Exequiel25/Amplificador-Mono-1-W-discreto/Proyecto Final EA1-Magni Genre,Exequiel Juan.docx

Definición del problema:

Como parte de los requerimientos de aprobación y/o regularización de la materia Electrónica aplicada I se plantea la necesidad de construir un sistema que plasme/aplique los conocimientos adquiridos en dicha materia. Dicho trabajo deberá ser presentado funcionando (simulado) y con su respectivo informe.

Solución propuesta:

Construcción de un amplificador de guitarra de 1 W de potencia de verdadero valor eficaz.

Justificación:

Un amplificador de guitarra integra gran parte del contenido y conceptos del programa analítico de la materia. Por lo que resulta una buena opción como tema de trabajo final.

Temas del progrma incluidos:

- Tema 1: Señales y sistemas electrónicos
- Tema 2: Transistor bipolar con señales débiles
- Tema 3: Transistor unipolar con señales débiles
- Tema 4: Transistor con señales fuertes
- Tema 5: Estabilidad del punto de reposo
- Tema 6: Amplificadores multietapa
- Tema 7: Fuentes de corriente constante
- Tema 8: Amplificador diferencial
- Tema 9: Fuentes de alimentación lineales

Objetivos:

- Integrar y aplicar los conceptos vistos en la materia y en otras también.

Alcances y limitaciones:

El circuito está diseñado para trabajar en la banda de audiofrecuencias (20 Hz~20 kHz), aunque consideramos que la mínima frecuencia que puede generar una guitarra es 82,4069 Hz y la máxima frecuencia, para una eléctrica, es 1318,51 Hz fundamental y 3,5 kHz armónico. Al ser baja potencia (1 W) relativa a otros amplificadores, tendrá la limitación de no ser útil en espacios muy abiertos si el objetivo es conseguir un volumen considerable. Como ventaja, se puede ajustar para que sea utilizable con auriculares. Es de suma importancia saber que dicho amplificador está diseñado para operar con impedancias de entrada de entre los 5 a 15 kΩ y de carga de 6 u 8 Ω para parlantes y 32 Ω para auriculares, con respectivas adaptaciones.

Diagrama de bloques del amplificador para guitarra:

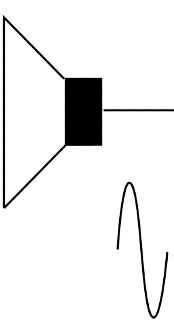
[picture p1: figure]

ETAPA ENTRADA

ETAPA AMPLIFICADORA

ETAPA ADAPTADORA

GUITARRA

(eléctrica o

acústica)

CARGA

8 Ω

Diagrama representativo de un Amplificador de Tensión:

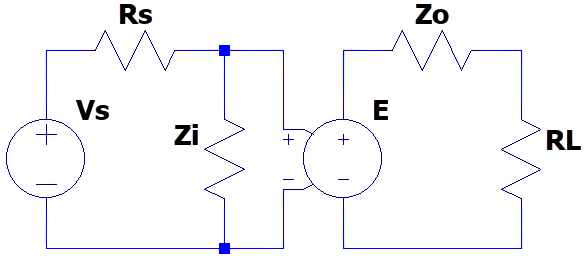
[picture p2: figure]

- Condiciones del amplificador:
  - Comprende señal de entrada desde Vs≈100mV hasta Vs≈200mV (según pastilla de bobinado en las eléctricas)
  - Zi≫Rs y Zo≪RL
  - La resistencia de salida (Rs) del instrumento es 5kΩ≤Rs≤15kΩ
  - Trabajamos con una resistencia de carga (parlante): RL=8Ω
  - Por lo tanto la impedancia de entrada debe ser Zi>200kΩ
  - Y la impedancia de salida debe ser Zo<10Ω
  - Potencia 1Wrms (este parámetro es obligatorio)

Síntesis:

Consideraciones:

Es lógico pensar que en el momento de usar un auricular no se alcance la misma potencia que cuando se utiliza un parlante de 8 Ω. Por lo tanto, la potencia de 1 W está apuntada al diseño para el parlante de 8 Ω.

La inversión de la señal a la salida del amplificador tiene relevancia cuando la salida es estéreo o cuando se realizan mezclas, lo que no es este caso.

Se debería agregar una Red de Zobel antes del parlante. Sin embargo, consideramos al parlante como una resistencia pura sin la necesidad de incluir dicha red. Tampoco se incluirá elementos de control de tono, volumen y ganancia.

Primer diseño propuesto:

En la primera etapa colocar un seguidor de fuente, el cual tiene baja ganancia de tensión (Av<1), pero su impedancia de entrada es elevada y su impedancia de salida es baja. A continuación, la segunda etapa sería un transistor bipolar en configuración de emisor común encargado de dar la ganancia de tensión necesaria del amplificador en su conjunto. Y la etapa adaptadora se conformaría de un seguidor de emisor, ya que su impedancia de entrada es elevada y su impedancia de salida es baja.

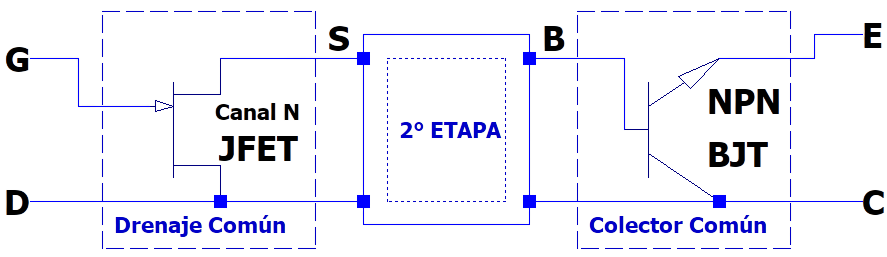
[picture p3: figure]

Este diseño conlleva muchas problemáticas debido a que la segunda etapa debía tener una ganancia muy elevada, ya que tanto la etapa de entrada como la etapa de salida tienen una ganancia de tensión inferior a 1, y esto a su vez llevaba a relaciones de compromiso con las impedancias de entrada y salida. Para mejorar dicha situación, se deberían agregar más etapas, haciendo más costoso al amplificador. Principalmente por este motivo, se decidió descartar esta idea.

Segundo diseño propuesto:

Comenzando desde la carga, se propone como etapa adaptadora, mantener un seguidor de emisor con un par Darlington, y así contrarrestar los bajos valores de β en los amplificadores de potencia. La etapa amplificadora constará también de un emisor común (BJT) o un surtidor común (JFET). Finalmente, para la primera etapa se sugiere un amplificador diferencial.

Dada las condiciones planteadas del amplificador de tensión, la mejor alternativa para la etapa de entrada es un amplificador diferencial, por la inmunidad al ruido, es con dispositivos FET, debido a su alta impedancia de entrada disminuyendo así valores de resistencias y, por lo tanto, el ruido térmico.

La ganancia será satisfecha gracias a la primera y segunda etapa, a diferencia del primer diseño. Esto permite valores de ganancia pequeños para mantener un gran ancho de banda (BW) del amplificador. Además, facilitamos el diseño para evitar distorsión en la señal amplificada y reducimos el valor de la fuente de alimentación de corriente continua (DC).

Finalmente, para la segunda etapa se obtó por un emisor común, el cuál lleva una ventaja respecto a la dispersión de parámetros de los dispositivos respecto a los JFETs. Este último se podría haber solucionado polarizando al dispositivo con una fuente de corriente, pero estoy lleva a encarecer y dificultar el diseño. Además, se volvió complicado diseñar una red de polarización tal que cumpliera con las especificaciones dadas, ya que la impedancia de salida de los JFETs en configuración de surtidor común es media-alta lo que no es eficiente para la transferencia de tensión.

Pasos del diseño ETAPA 3-Par Darlington:

1. Determinar el valor de la carga y forma de acople al amplificador.

R_L =8Ω , se acopla por medio de un capacitor.

2. Determinar corriente y tensión en la carga para que haya 1 Wrms

P_(RMS) =1W=(V_p^2)/(2R)=(I_p ²)/2R

    (a) V_(RMS) =(V_p)/(√2) , V_p =4,00V∧V_(RMS) ≈2,83V
    (b) I_(RMS) =(I_p)/(√2) , I_p =0,50A∧I_(RMS) ≈0,35A
3. Calcular corriente de emisor IEQ necesaria para que no haya distorsión:

I_(EQ) ≥I_(e(max)) =(V_(L(max)))/(R_E ∥R_L)

- Con R_E =12Ω :

I_(e(max)) ≈0,833A⇒I_(E(sat)) =I_(EQ) +I_(L(max)) ≈1,33A⇒(V_(CC))/(R_E)=1,33A⇒V_(CC) ≈16V

- Con R_E =20Ω :

I_(e(max)) ≈0,7A⇒I_(E(sat)) =I_(EQ) +I_(L(max)) ≈1,2A⇒(V_(CC))/(R_E)=1,2A⇒V_(CC) ≈24V

Se decide optar por RE=20 Ω para que haya una mayor transferencia de tensión hacia la carga.

4. Elección de transistores:

BC141: https://alltransistors.com/es/transistor.php?transistor=22321

BCP56: https://www.nxp.com/docs/en/data-sheet/BCP56_BCX56_BC56PA.pdf

Se elige 2 transistores BC141-16

5. Calcular RB

R_E ≫(R_B)/β⇒R_B <0.1βR_E =20,4kΩ ,, donde β=β_D =β_1 β_2 +β_1 +β_2 =10200conβ_(min) =100

V_(BB) =I_E (R_E +(R_B)/(β_D))+2V_(BE) ≈16,8V

R_(B1) =V_(CC) (R_B)/(V_(BB))≈29142Ω , se aproxima a valor comercial más cercano: 27 kΩ

R_(B2) =V_(CC) (R_B)/(V_(CC) −V_(BB))=68kΩ

Entonces:

R_(B1) =27kΩ∧R_(B2) =68kΩ⇒R_B ≈19,33kΩ , esta aproximación es un 5,25% más bajo que el límite establecido anteriormente R_B =20,4kΩ , es decir, estamos sacrificando un poco de estabilidad para obtener una mayor impedancia de entrada y aumentar la transferencia de tensión de la etapa anterior.

6. Calcular capacitores:

C_i ≈5/(πfR_B)→420nF∧C_o ≈5/πfR_E →440μF

7. Calcular impedancias:

Resistencia de entrada a la base: R_(ent(base)) =(V_(ent))/(I_(ent))=(V_b)/(I_b) ; siendo V_b =I_e (r'_e +r'_e +R_E ∥R_L ) y I_b =(I_e)/(β_(ac)) .

R_(ent(base)) =(I_e (2r'_e +R_e ))/((I_e)/(β_(ac)))⇒R_(ent(base)) =β_(ac) (2r'_e +R_e ) ; r'_e ≈(25mV)/(I_(EQ))≈35,71mΩ

  a) Impedancia de entrada: Z_i =R_B ∥R_(ent(base)) ≈15,4kΩ
  b) Impedancia de salida: Z_o ≈R_E ∥R_L ≈5,71Ω
8. Calcular ganancia:

A_v =(V_o)/(V_i)=(V_e)/(V_b)=(I_e R_e)/(I_e (2r'_e +R_e ))=(R_e)/(2r'_e +R_e)≈0,988 ; cumple el objetivo de llevarla lo más cercano a 1

Este valor impone una condición sobre las demas etapas.

Siendo que A_(vTotal) =(V_o)/(V_i)=(4,05)/(0,1)=40,5=A_(v1) ⋅A_(v2) ⋅A_(v3) ⇒A_(v1) ⋅A_(v2) =(40,5)/(A_(v3))≈41 ; por lo tanto, podemos proponer ganancias de 10 y 4 para las etapas 1 y 2. Es conveniente que la primer etapa sea la que más amplifique debido a que su señal de entrada es más débil.

9. Simulación

La tensión que debe llegar a esta etapa es V_(i3) =4,15V . De la simulación obtenemos los siguientes datos:

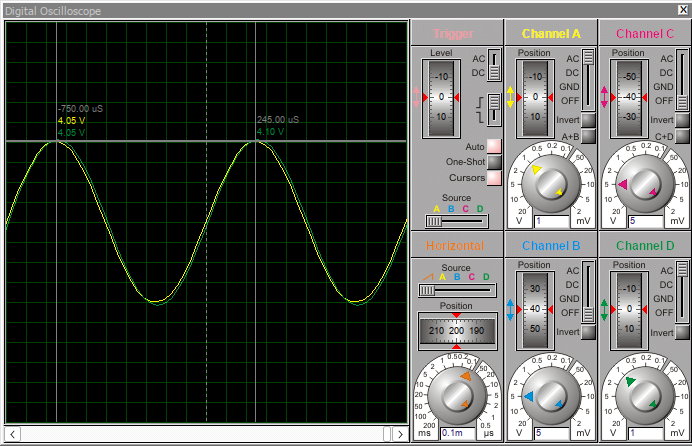
[picture p4: figure]

V_o =4,05V⇒ϵ_((%)) =(4,05−4,00)/(4,00)x100=+1,25%

A_v ≈0,98

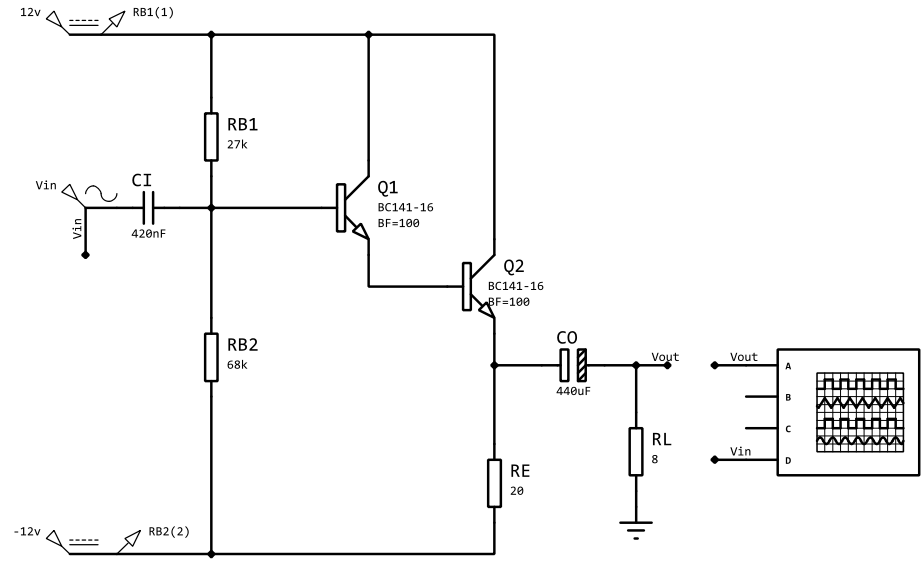
[picture p5: figure]

Transistor Q1:

V_(CEQ) =8,876V

I_(EQ) =7,264mA

P=64,54mW

El dispositivo no requiere de disipador.

Transistor Q2:

V_(CEQ) =9,821V

I_(EQ) =733,6mA

P=7,212W ; verificar

Debido a que la potencia del transistor Q2 supera los 3,7 W (potencia PD que disipa el encapsulado) se debe agregar un disipador.

Modelado térmico:

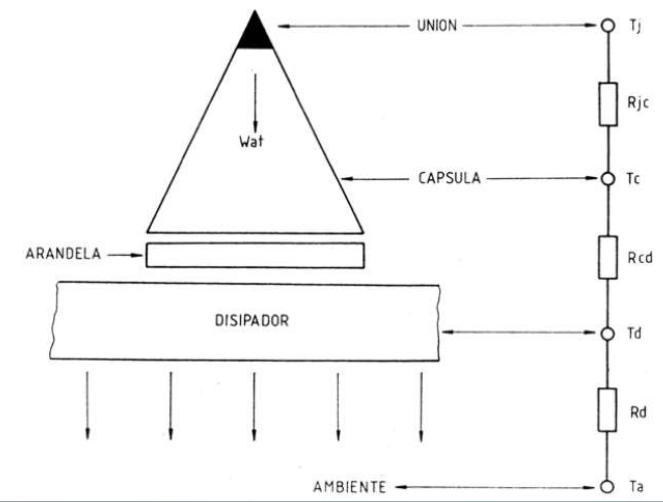
[picture p6: figure]

Circuito equivalente:

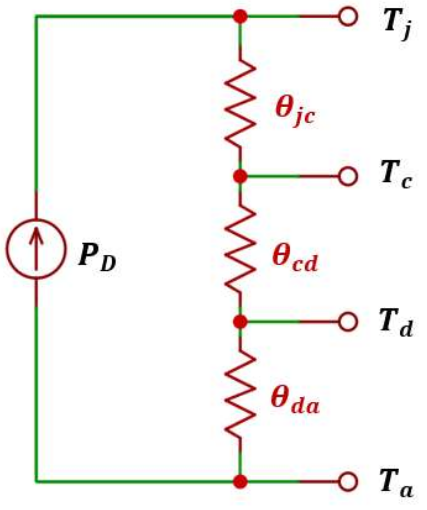
[picture p7: figure]

Del datasheet obtenemos los datos, el único problema es que hay un error en el datasheet encontrado anteriormente, por lo que se recurrió al siguiente:

https://www.st.com/resource/en/datasheet/cd00003226.pdf

P_D =7,212W ; T_(j−max) =175°C ; −65°C<T_a <150°C ; R_(θ−ja) =200°C/W ; R_(θ−jc) =35°C/W

Corroboramos la necesidad de calcular un disipador:

7,212W=(T_j −T_a)/(θ_(ja))⇒T_j ≈1467,4°C>T_(j−max)

Hacemos que Tj esté lo menos cercano al valor Tj máximo T_j =kT_(j−max) donde 0,5≤k≤0,7

Por criterio, podemos obtar por un k=0,6 para economizar las dimensiones del disipador. Entonces:

P_D =(kT_(j−max) −T_a)/(θ_(jc) +θ_(cd) +θ_(da)) ; donde kT_j =105°C

Siendo que elegimos contacto directo con grasa siliconada y el encapsulado es TO-39: R_(θ−cd) =0,7°C/W

Entonces:

θ_(da) =(kT_(j−max) −T_a)/(P_D)−(θ_(jc) +θ_(cd) )≈−24,61°C

Observamos que el valor es negativo, es decir, no existe un disipador que permita trabajar en estas condiciones. Podemos llevar k a un valor de 0,7: θ_(da) ≈−22,18°C . Vemos que el valor sigue siendo negativo, por lo que otra solución sería recurrir a la refrigeración forzada por medio de ventiladores, aunque para la naturaleza del proyecto esta opción queda descartada. Vemos que el problema radica principalmente en que la resistencia juntura-carcasa máxima posible, indicada por el fabricante, es muy elevada. Por ende, sería conveniente buscar otro transistor.

Dado que el diseño de la etapa ya fue realizado, es conveniente buscar un transistor que posea características similares, pero mejore la disipación de potencia.

Un candidato es el BUP41: https://pdf1.alldatasheet.es/datasheet-pdf/view/441217/ISC/BUP41.html

Con el cual, según indica el fabricante (http://www.iscsemi.cn/en/list/?84_1.html), se garantiza disipar 10 W de potencia, por lo que no sería necesario agregar un disipador.

Vemos en la simulación que no hay mucho cambio debido a que el diseño se realizó para transistores con un beta mínimo de 100.

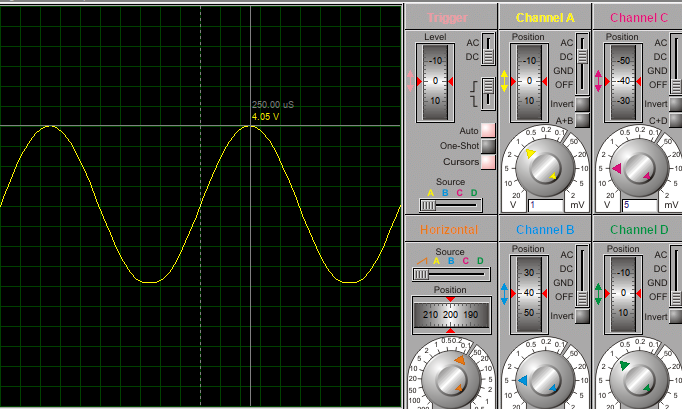
[picture p8: figure]

Pasos del diseño ETAPA 2-Emisor Común:

1. Condiciones fundamentales de la etapa:

A_v =−4,2

Z_o ≪Z_(i(etapa3)) =14,56kΩ⇒Z_o ≤1456Ω

10. Calculos para obtener ganancia de tensión y corriente requerida para evitar la distorsión:

A_v =(−R_c)/(r'_e)≈(R_c)/((25mV)/(I_(CQ)))=(I_(CQ) R_c)/(25mV)

Si R_C =1kΩ⇒R_c ≈943,25Ω∧I_(CQ) ≈111,32μA

I_(CQ) ≥I_(c(max)) =(V_(o(max)))/(R_C ∥R_L) ; V_(o(max)) =4,15V

I_(CQ) ≥4,4mA La corriente de alterna para obtener determinada ganancia no coincide con la mínima necesaria para evitar distorsión.

Introducimos una resistencia RE para alterna.

A_v =(−R_c)/(R_E +1/(g_m)) ; si R_E ≫1/(g_m)⇒A_v ≈(−R_c)/(R_E)

R_E +1/(g_m)≈(R_c)/(A_v)≈224,58Ω∧R_E =10/(g_m)⇒g_m ≈48,98mS=(I_(CQ))/(25mV)⇒I_(CQ) ≈1,22mA

R_E =200Ω ; pero la corriente resultante sigue siendo menor que la corriente necesaria para no provocar distorsión. Por ende, añadimos una segunda resistencia RE en paralelo con un capacitor y así no influenciar el cálculo de la ganancia.

I_(CQ) =4,5mA ; R_(E1) =200Ω

V_(CC) −I_(CQ) R_C −V_(CEQ) −I_(EQ) R_E =0⇒R_E ≈1,667kΩ

R_E =R_(E1) +R_(E2) ⇒R_(E2) =R_E −R_(E1) ≈1,5kΩ

11. Elección del transistor:

BC548: https://pdf1.alldatasheet.es/datasheet-pdf/view/11552/ONSEMI/BC548.html

12. Calcular RB

R_B ≤0,1βR_E ≈17kΩ , donde β_(min) =100

V_(BB) −I_B R_B −V_(BE) −I_E R_E =V_(EE) ⇒V_(BB) =I_E (R_E +(R_B)/(β_D))+V_(BE) ≈9,746V

R_(B1) =V_(CC) (R_B)/(V_(BB))≈44761Ω→43kΩ

R_(B2) =V_(CC) (R_B)/(V_(CC) −V_(BB))≈27410→27kΩ

Entonces:

R_(B1) =43kΩ∧R_(B2) =27kΩ⇒R_B ≈16,59kΩ , es un 0,001% más bajo que el límite R_B =17kΩ

13. Calcular capacitores:

C_i ≈5/(πfR_B)→480nF∧C_o ≈5/πfR_C →8μF∧C_E ≈5/(πfR_(E2))≈6uF

14. Calcular impedancias:

Resistencia de entrada a la base:

R_(ent(base)) =(V_b)/(I_b)=(I_e (r'_e +R_(E1) ))/((I_e)/(β_(ac)))=β_(ac) (r'_e +R_(E1) )≈20,52kΩ

  a) Impedancia de entrada: Z_i =R_(ent(base)) ∥R_B ≈9,17kΩ
  b) Impedancia de salida: Z_o ≈R_c =R_C ∥R_L ≈935,73Ω
15. Calcular ganancia:

A_v =(V_o)/(V_i)=(V_c)/(V_b)=(I_c R_c)/(I_c (r'_e +R_(E1) ))=(R_c)/(r'_e +R_(E1))≈4,561

16. Simulación

La tensión que debe llegar a esta etapa es V_(i2) =1V . De la simulación obtenemos los siguientes datos:

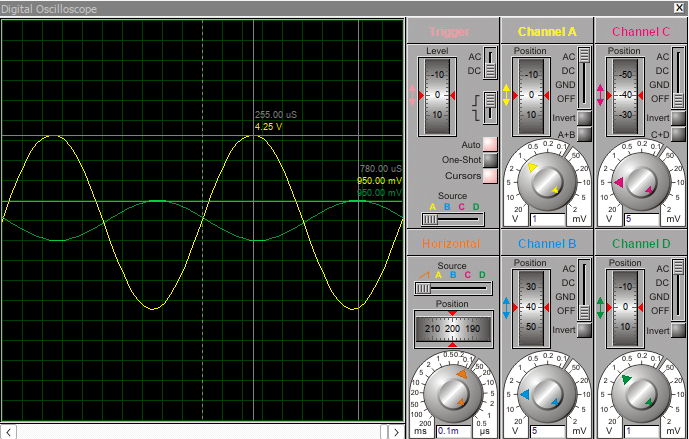
[picture p9: figure]

V_o =4,25V⇒ϵ_((%)) =(4,25−4,15)/(4,15)x100=+2,4%

A_v =−4,25⇒ϵ_((%)) =(4,25−4,2)/(4,2)x100=+1,19%

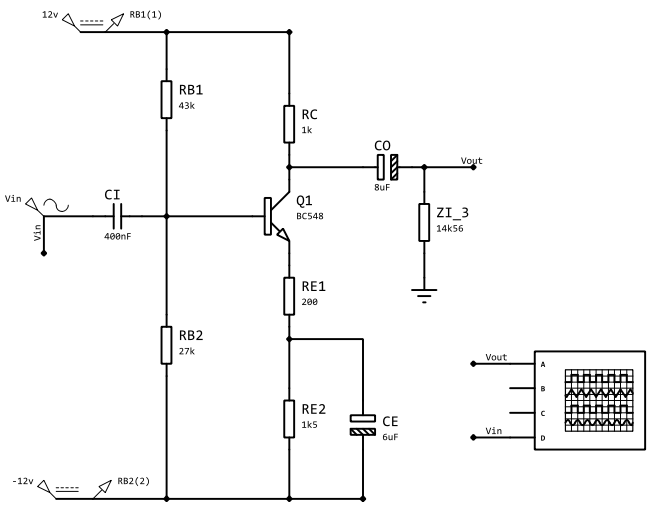
[picture p10: figure]

Transistor Q1:

V_(CEQ) =10,27V

I_(EQ) =5,518mA

P=56,69mW

El dispositivo no requiere de disipador.

Pasos del diseño ETAPA 1-Amplificador Diferencial (JFETs):

Se usará en modo diferencial, donde la entrada no inversora se conecta a masa y se inyecta la señal por la entrada inversora.

Se supone que los transistores son iguales.

Por el rechazo en modo común la señal no deseada (ruido) que aparece comúnmente en ambas entradas de un amplificador diferencial se anula.

Configuración salida asimétrica – entrada asimétrica.

La ganancia en modo común disminuye drásticamente al polarizar con una fuente de corriente constante, ya que la resistencia de fuente es una resistencia de gran valor. En consecuencia aumenta CMRR y la impedancia de entrada en modo común (menos sensible al ruido). Además, una ventaja de polarizar con una fuente de corriente implica mayor estabilidad.

1. Condiciones fundamentales de la etapa:

A_v =−9,84≈−10 ; debido a que por aproximaciones suele ser menor.

Z_o ≪Z_(i(etapa3)) =9,26kΩ⇒Z_o ≤926Ω

17. Calculos para obtener ganancia de tensión y corriente requerida para evitar la distorsión:

A_(dm) =(g_m R_d)/2=(I_(DSS))/(V_p)(1−(V_(GS))/(V_p))R_d

I_(DSS) =10mA∧V_(GS(off)) =V_p =−1V

Con R_D =900Ω⇒R_d ≈820,28Ω

I_(DQ) ≥I_(d(max)) =(V_(o(max)))/(R_D ∥R_L) ; V_(o(max)) ≈1V

I_(DQ) ≥1,22mA

A_v =(g_m R_D)/2⇒g_m =2(A_v)/(R_D)≈22,22mS ; g_m =2(I_(DSS))/(V_p)(1−(V_(GS))/(V_p))⇒V_(GS) =−0,111 ;

I_D ≈I_(DSS) (1−(V_(GS))/(V_p))^2 ≈7,9mA ; es mayor que la corriente de drenaje mínima.

18. Elección del transistor:

2N3819: https://pdf1.alldatasheet.es/datasheet-pdf/view/111087/VISHAY/2N3819.html

19. Calcular fuente de corriente para polarización:

R_E =(V_(EE) −V_(BE))/(2I_(DQ))≈715,19Ω→680Ω

20. Calcular capacitores:

C_o ≈5/πfR_C →10μF

21. Recalcular ganancia:

A_v =(g_m R_D)/2=(I_(DSS))/(V_p)(1−(V_(GS))/(V_p))R_D ≈10

22. Simulación

La tensión que debe llegar a esta etapa es V_(is) =100mV . De la simulación obtenemos los siguientes datos:

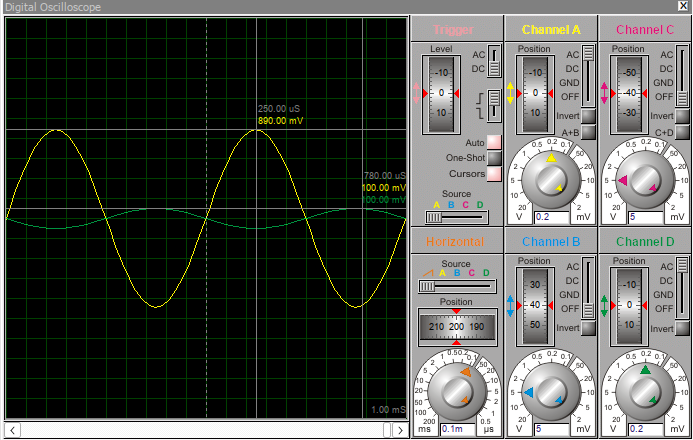
[picture p11: figure]

V_o =0,89V⇒ϵ_((%)) =(0,89−1)/1x100=−11%

Vemos que el valor de tensión de salida supera el 10% de error. Realizamos entonces una pequeña correcón en la fuente de corriente, la cuál está entregando un valor de corriente inferior a la requerida.

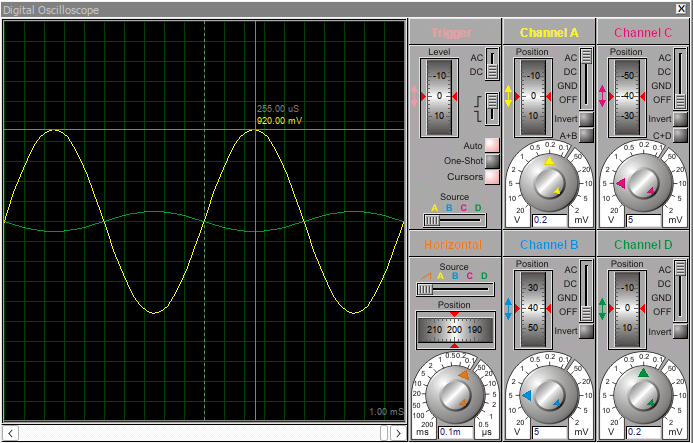
[picture p12: figure]

V_o =0,92V⇒ϵ_((%)) =(0,92−1)/1x100=−8%

A_v =−9,2⇒ϵ_((%)) =(9,2−10)/10x100=−8%

Es un valor más aceptable, por lo que se procede al ensamble del amplificador.

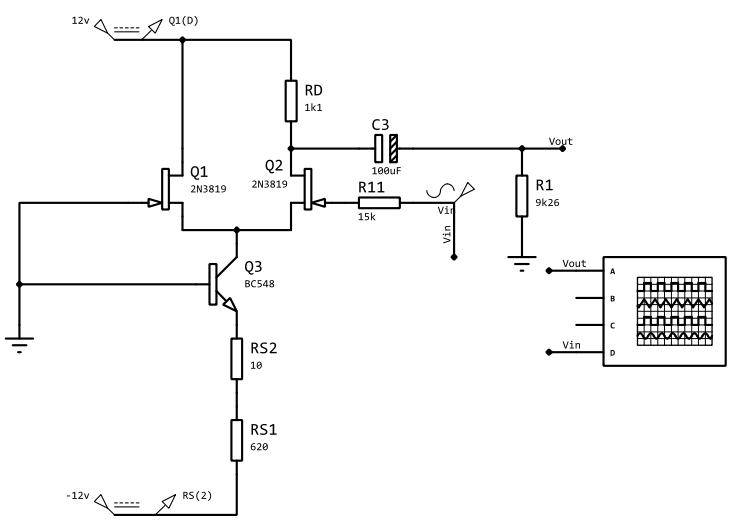
[picture p13: figure]

Transistor Q1:

V_(DSQ) =11,94V

I_(DQ) =8,874mA

P=106mW

Transistor Q2:

V_(DSQ) =2,19V

I_(DQ) =8,864mA

P=19,42mW

Transistor Q3:

V_(CE) =821,9mV

I_(DQ) =17,74mA

P=14,65mW

Ningún dispositivo requiere de disipador.

Simulación del amplificador diseñado

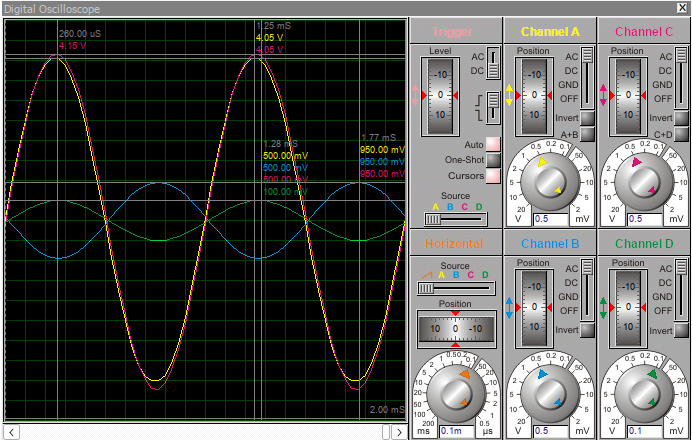
[picture p14: figure]

Legenda:

V_(oL) =4,05V⇒ϵ_((%)) =(4,05−4,05)/(4,05)x100=0% Amarrillo = Señal de salida en la carga

V_(o1°) =950mV⇒ϵ_((%)) =(0,95−1)/1x100=−5% Azul = Señal de salida de la primera etapa

V_(o2°) =4,15⇒ϵ_((%)) =(4,15−3,97)/(3,97)x100=+4,53% Rojo = Señal de salida de la segunda etapa

V_i =100mV;f=1kHz Verde = Señal de salida del instrumento / Señal de entrada al amplificador

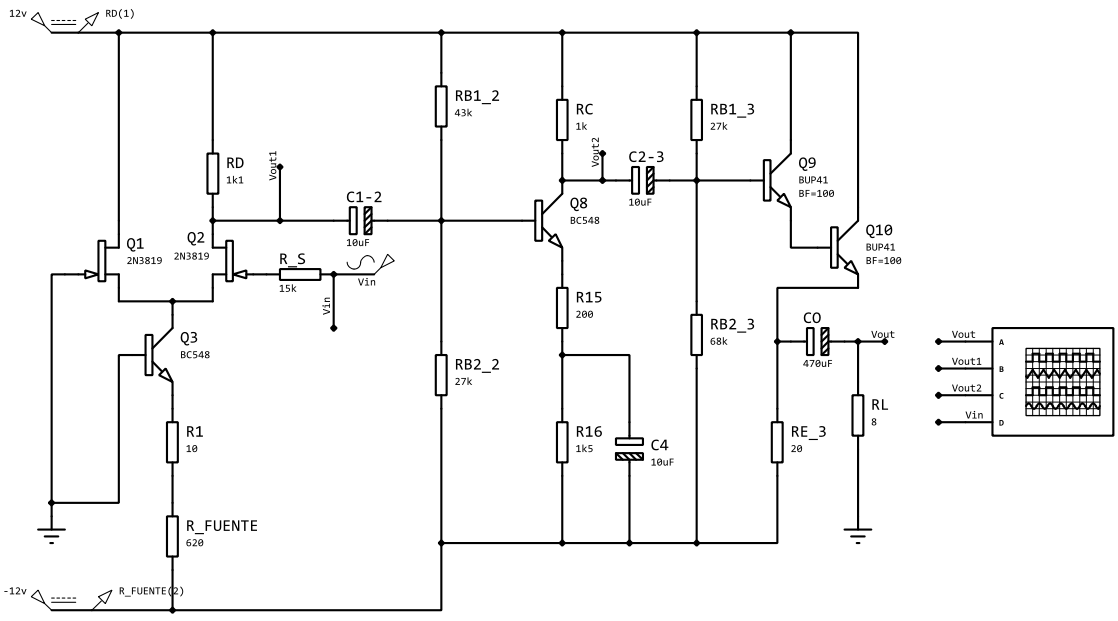
[picture p15: figure]

A_(v1) =(950mV)/(100mV)=−9,5⇒ϵ_((%)) =(9,5−10)/10x100=−5%

A_(v2) =(4,15V)/(0,95V)=−4,37⇒ϵ_((%)) =(4,37−4,2)/(4,2)x100=+4,05%

A_(v3) =(4,05V)/(4,15)=0,975⇒ϵ_((%)) =(0,975−0,98)/(0,98)x100=−0,51%

A_V =A_(v1) ⋅A_(v2) ⋅A_(v3) =40,48

Conclusión: El amplificador diseñado cumple con el objetivo planteado en ganancia, y, por lo tanto, en potencia, ya que para la carga planteada se tiene la tensión objetivo.

Aclaración: Cabe destacar que debería modificarse el valor de RD o RC y colocar un potenciómetro en serie para el control de ganancia. Una propuesta es una resistencia RD de 100 Ω y un potenciómetro logarítmico de 1 kΩ.

Además, los capacitores de 6 μF y 8 μF se aproximan a 10 μF y el de 440 μF se aproxima a 470 μF.

Análisis ancho de banda:

Recordamos que V_(oL) =4,05V . Consideramos las frecuencias de corte como aquella en que la ganancia es el 70% de su valor nominal. Siendo que la señal de entrada es constante, la variable que varía es la señal de salida. Por lo tanto, las frecuencias de corte se encuentran a 70% de la señal de salida: V_(oL) =2,84V .

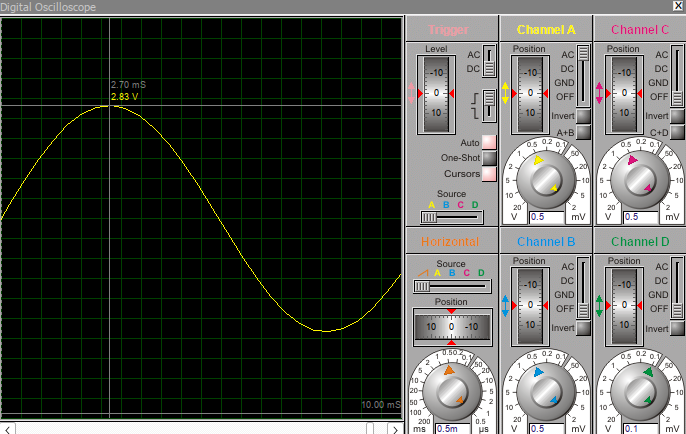
[picture p16: figure]

Frecuencia de corte inferior: f_(inferior) =92Hz

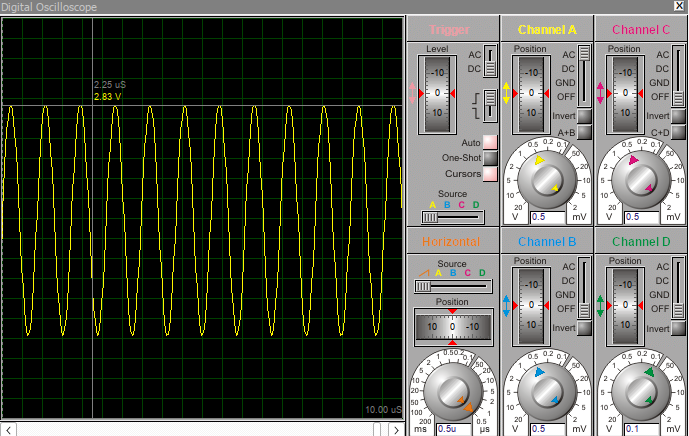
[picture p17: figure]

Frecuencia de corte superior: f_(superior) =1,14MHz

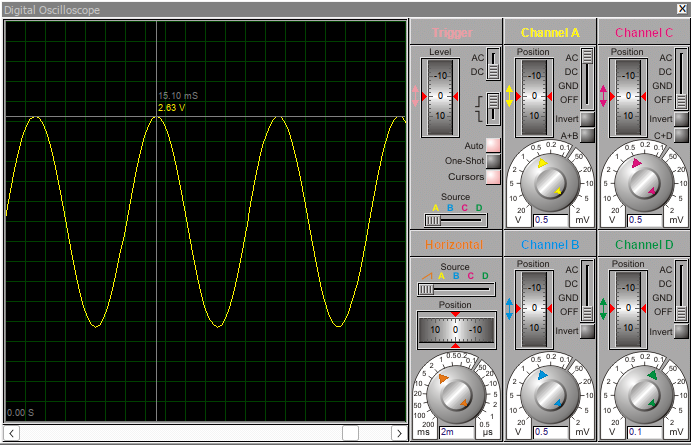
[picture p18: figure]

Conclusión: Se debería corregir la frecuencia de corte inferior, ya que, a pesar de encontrarse en un valor cercano, es un valor por encima de la frecuencia mínima de la guitarra (82,4 Hz). A esta frecuencia, la ganancia es de A_(vinf) =26,3 que representa el 65% de la ganancia nominal.

Tabla de materiales y componentes (Amplificador):

Componente | | Cantidad | | Costo
Resistencias | 10 Ω 1/4W | | 1 | | $2,5
| 20 Ω 20W | | 1 | | $569,70
| 200 Ω 1/4W | | 1 | | $2,5
| 620 Ω 1/4W | | 1 | | $2,5
| 1k Ω 1/4W | | 1 | | $2,5
| 1k1 Ω 1/4W | | 1 | | $2,5
| 1k5 Ω 1/4W | | 1 | | $2,5
| 27k Ω 1/4W | | 2 | | $5
| 43k Ω 1/4W | | 1 | | $2,5
| 68k Ω 1/4W | | 1 | | $2,5
Capacitores | 10μF 16V | | 3 | | $1123,89
| 470μF 16V | | 1 | | $374,63
Transistores | 2N3819 (JFET) | | 2 | | $2048
| BC548 (BJT-NPN) | | 2 | | $623,9
| BUP41 (BJT-NPN) | | 2 | | US$6 → ARS$1014,9
TOTAL | | | 20 | | $6218,02

Fuente regulada

Una fuente de alimentación regulada ideal es aquella que entrega una tensión continua constante Vo, independientemente de la corriente Io que circula por la carga, de la temperatura y de cualquier variación de la tensión de entrada a la misma. Esto es necesario para alimentar a nuestro amplificador, dado que si existe variación en la fuente +Vcc y -Vcc, se verá afectado el tratamiento de la señal por parte del amplificador. Es decir, existirá inestabilidad en el amplificador de audio, debido a la inestabilidad de la fuente, dando espacio a la posibilidad de distorisión y amplificación no lineal.

Podemos considerar que la tensión de entrada de la fuente regulada es provista por una fuente no regulada constituida por un transformador, un rectificador y un filtro. Este tipo de fuente posee mala regulación y cualquier variación de, por ejemplo la tensión de entrada, producirá variación de la tensión de salida, por lo que debe agregársele un dispositivo o circuito regulador.

La desventaja de un regulador paralelo es su bajo rendimiento, debido a las altas pérdidas de potencia en las resistencias serie y el transistor paralelo. Cuando el rendimiento no es importante (típicamente para bajas corrientes de carga), se pueden utilizar los reguladores paralelo, ya que presentan la ventaja de su simplicidad. En contraste, un regulador serie tiene rendimientos entre el 50 y 70 %, lo que está bien para la mayoría de las aplicaciones en las que la potencia en la carga es menor a 10 W. Por este motivo, se prefiere utilizar un regulador serie básico (seguidor de Zener sin necesidad de proteger al regulador de una elevada corriente).

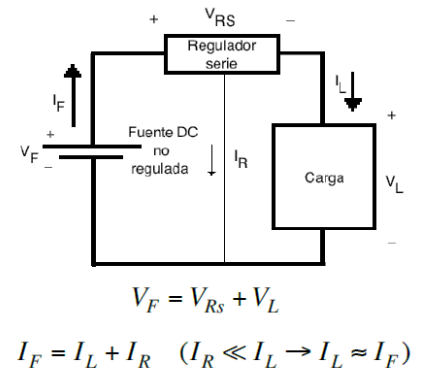
[picture p19: figure]

El elemento de control en serie actúa ajustando su caída de tensión interna Vc, de modo que la tensión de salida Vo se mantenga constante para las variaciones de la tensión de entrada y de la corriente de carga.

La máxima potencia disipada en el elemento de paso está dada por:

PD máx = (Vi máx – V0 mín) · I0 máx

Procedimiento de diseño:

La corriente total que consume el amplificador es la suma de corriente de las etapas, por lo tanto, se tiene que: I_o =8,489mA+8,482mA+349,6μA+4,839mA+302μA+6,9mA+696,9mA≈0,726A

Los pasos del diseño empiezan desde la carga hacia el principio.

- Resistencia de carga:

R_L =(V_o)/(I_o)=(24V)/(0,726A)≈33,06Ω

Como es una fuente simétrica, cada etapa rectificadora “ve” la mitad de la carga, pero entregará la mitad de corriente por lo que mantiene su valor de carga: R_(L(amplificador)) ≈33,06Ω .

- Regulador:

Una vez establecida la carga, conocemos la potencia necesaria de los transistores a utilizar en los reguladores. Cada regulador tendrá una potencia P_(min) =V_(CEQ(sat)) ⋅I_(CQ) , donde V_(CEQ(sat)) =V_(CB) +V_(BE) . Para garantizar que la juntura colector-base quede polarizada en inverso V_(CB) =1V∧V_(BE) =0,7V .

La tensión de entrada mínima al respectivo regulador (positivo o negativo) debe ser

±V_(i(min)) =±(1,7V+12V)=±13,7V ; que es la tensión de salida del filtro.

Para determinar el valor de entrada máximo, debemos establecer de antemano el valor porcentual de ripple. En este caso, tomaremos un nivel de ripple del 3% (de esta manera los transistores no tendrán que disipar un valor grande potencia máxima), por lo tanto, si V_(i(min)) =0,97V_(i(DC)) y V_(i(max)) =1,03V_(i(DC)) ; entonces:

V_(i(DC)) ≈14,12V⇒V_(i(max)) ≈14,55V

Por lo tanto, V_(CEQ(max)) =V_i −Vout=14,55V−12V=2,55V y P_(max) =2,55V⋅0,363A≈0,93W .

El factor de rizado será:

FR_(%) =(14,55V−13,7V)/(14,12V)x100≈6%

La tensión del Zener:

V_Z =V_(out) +V_(BE) =12,7V→13V

- Determinar transistores y diodo Zener:

La corriente máxima que circula por los transistores es I_C =0,363A y la tensión máxima V_(CE) =2,55V , con potencia máxima P_(max) =0,93W . Por lo tanto, el transistor que podemos utilizar es un BD131 https://alltransistors.com/es/adv/pdfview.php?doc=bd131.pdf&dire=_philips (para el regulador positivo) y BD132 https://alltransistors.com/es/adv/pdfview.php?doc=bd132.pdf&dire=_philips. Ninguno requiere de disipador. Lo negativo es que su beta mínimo es 40, por lo que la corriente del Zener será:

I_(Z(max)) =1/(β+1)⋅(I_(L(max)) (V_(i(max)) −V_Z )−I_(L(min)) (V_(i(min)) −V_Z ))/(V_(i(min)) −0,97V_Z −0,03V_(i(max)))≈11,52mA

P_Z =149,76mW

Si se quisiera reducir esta potencia, podría agregarse un transistor en arreglo Par Darlington para obtener un beta mayor, así la Iz será menor y por lo tanto, lo será la potencia Pz.

- Resistencia RS:

R_S =(V_(i(max)) −V_Z)/(I_(Z(max)) +(I_(L(min)))/(β+1))≈76Ω→75Ω

- Verificación en simulación:

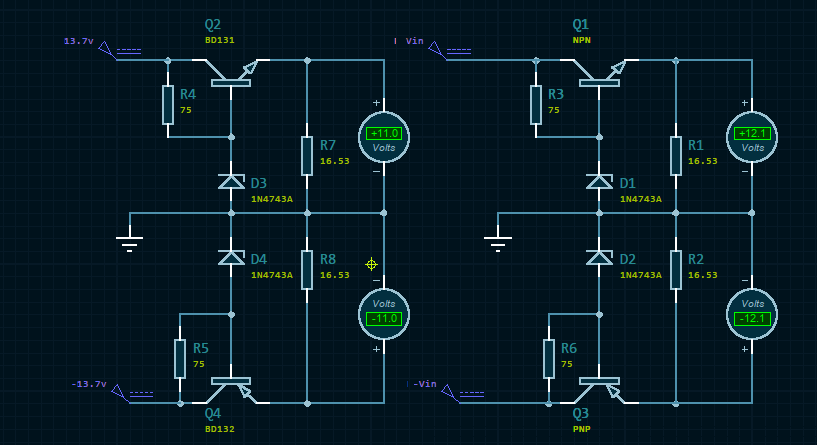
[picture p20: figure]

Como se puede observar, a la izquierda se encuentra el diseño finalizado y a la derecha se encuentra el diseño con dispositivos NPN y PNP genércios. Lo interesante a la hora de simular, es que ambos circuitos arrojan resultados diferentes. Esto puede ser debido a cómo estén modelado los componentes en el software de simulación.

Para solucionar este problema, se podría bien aumentar el valor de entrada, o incluir un potenciómetro en lo que corresponde a las resistencias Rs de cada regulador para poder hacer ajustes si el circuito se llevase a la práctica.

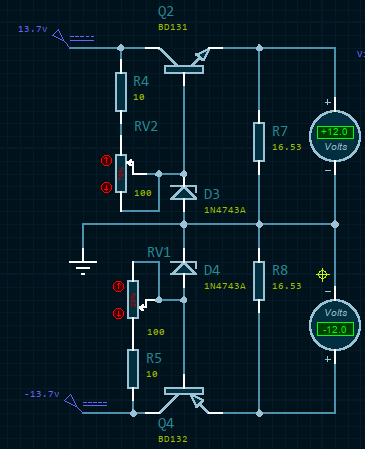
[picture p21: figure]

El valor de Rs ajustado por software es 25 Ω.

- Diseño etapas de filtrado y rectificación:
  - Cálculo de RL:

Debemos considerar que el valor de RL que ve el filtro no es solo el amplificador, sino también el regulador. La corriente sigue siendo 0,762 A pero la tensión es 27,4 V:

R_L =(27,4V)/(0,762A)≈35,96Ω

  - Se adopta la resistencia Rs de la fuente no regulada, el criterio es 0,01R_L ≤R_S ≤0,1R_L , esto es así porque no se conoce de forma precisa su valor dado que dicha resistencia incluye la resistencia del arrollamiento secundario del transformador y la resistencia que presentan los diodos cuando conducen.
    - Si Rs = 0,01RL mejora la regulación, pero hace que la corriente de pico no repetitiva (IPNR ) sea grande.
    - Si Rs = 0,1RL, la regulación no es tan buena en comparación al caso anterior, pero sigue siendo aceptable y además hace que la corriente de pico no repetitiva no sea muy alta.

Se propone entonces: R_S =0,06R_L ⇒(R_S)/(R_L)x100≈6%

  - Se ingresa en la primera de las curvas de Schade los datos determinados y se obtiene el parámetro ωωCRL , con lo cual se despeja el valor de capacitancia necesario para cumplir con la especificación de ripple

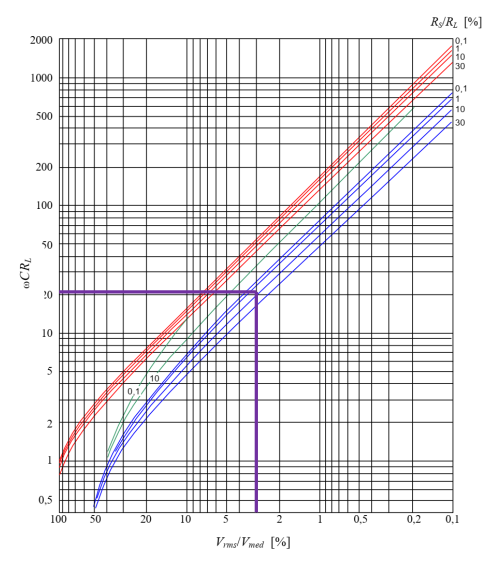
[picture p22: figure]

ωCR_L ≈22⇒C≈22/(ωR_L),f=50Hz⇒1,95mF→paraque(V_(ripple))/(V_(med))(%)≤3%⇒C≥1950μF→C=2200μF

ωCR_L ≈24,85

  - En la siguiente curva se obtiene la razón de conversión entre la tensión de pico y la componente de continua que se logra

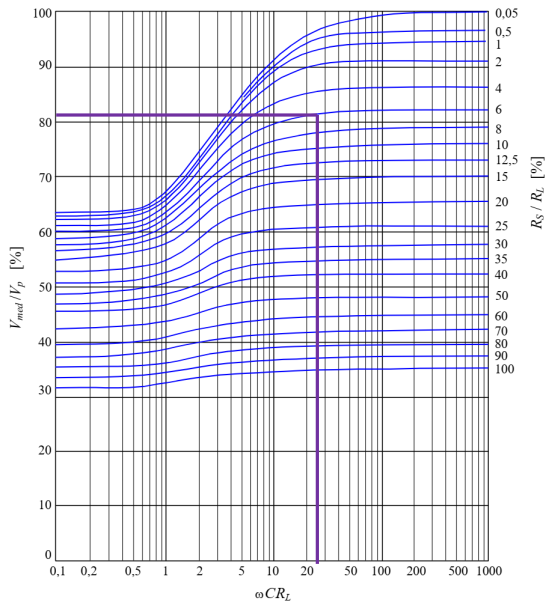
[picture p23: figure]

(V_(med))/(V_p)[%]≈82⇒V_(med) ≈0,82V_p ∧V_p ≈(V_o)/(0,82)=(13,7)/(0,82)V≈16,71V , tensión pico o de cresta que debería entregar el secundario del transformador en condición de vacío.

  - Cálculo tensión eficaz en el secundario del transformador:

V_(2°_(RMS)) ≈(V_p)/(√2)≈11,82V→12V

Transformador de 220:12

  - De la siguiente gráfica se obtiene la razón porcentual entre la corriente eficaz y la corriente media por cada diodo, con el agregado de un coeficiente n que depende del tipo de rectificación empleada, siendo n = 1 para media onda y n = 2 para onda completa (nuestro caso):

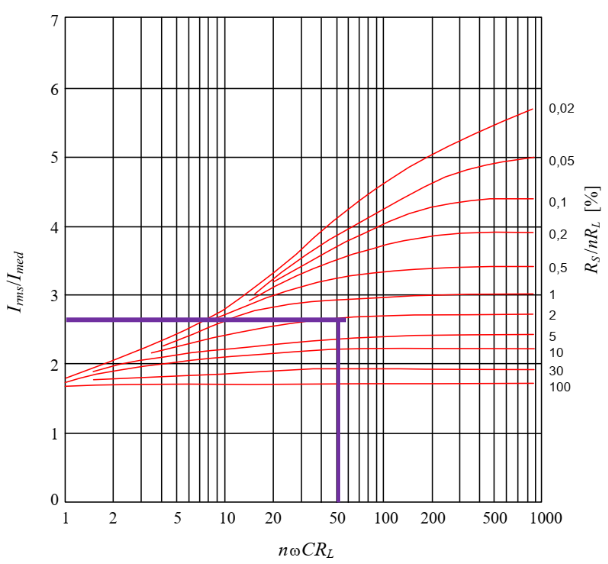
[picture p24: figure]

Datos: (R_S)/(2R_L)[%]=3%∧2ωCR_L =49,7≈50

(I_(rms))/(I_(med))≈2,6⇒I_(rms) ≈2,6I_o ≈1,981mA

Es la corriente que circula por el devanado secundario del transformador, por lo tanto, el transformador debería soportar una corriente eficaz mayor a 1,98 A por el secundario, en cuyo caso se puede elegir un transformador de 3 A

  - Se obtiene la corriente de pico repetitiva (corriente periódica pulsante), que en general es mucho más alta que la corriente eficaz:

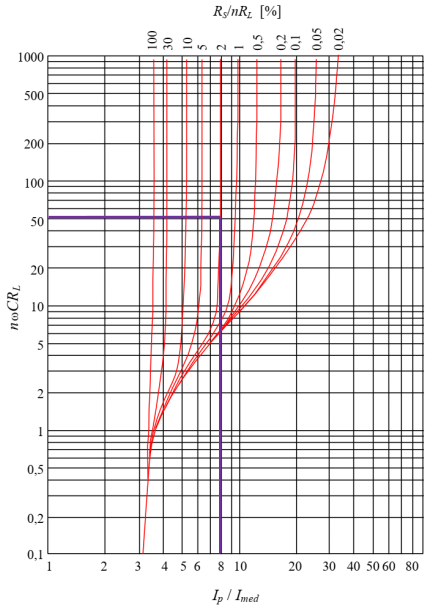
[picture p25: figure]

(I_p)/(I_(med))≈7,2⇒I_(pR) ≈5,49A

Y la corriente de pico no repetitiva:

I_(pNR) =(V_p)/(R_S)=(16,71V)/(0,06⋅35,96)≈7,74A

los diodos presentes en el rectificador deben ser capaces de soportar una corriente

transitoria de 6,08 A (al menos teóricamente)

  - Considerando la pérdida de tensión en los diodos del puente rectificador (2 × 0,7 V ≈ 1,4 V) se tiene que la tensión pico del secundario:

V_(2°p) =V_p +2(0,7V)≈18,11⇒V_(2°_(RMS)) ≈12,8V_(RMS) →12

  - Relación de espiras del transformador y potencia que debe suministrar:

N=(V_1)/(V_2)=220/12=18,33⇒N_1 =18,33N_2

P_2 =V_2 I_2 =12V⋅5,49A=65,88W

  - Finalmente, la fuente debe ser simétrica por lo que el transformador deberá tener un punto medio con transformación 220:12 con respecto al punto medio.
- Se procede a la simulación de la fuente de corriente continua:

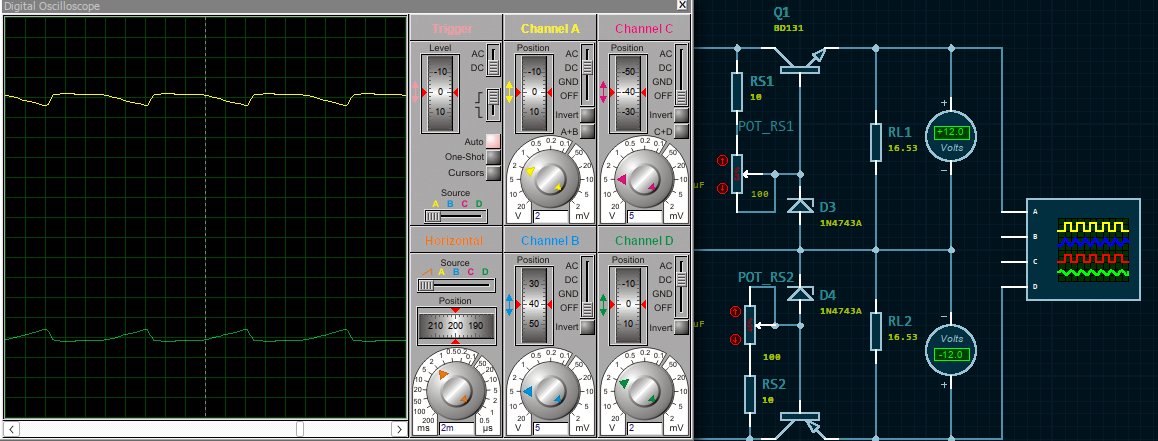
[picture p26: figure]
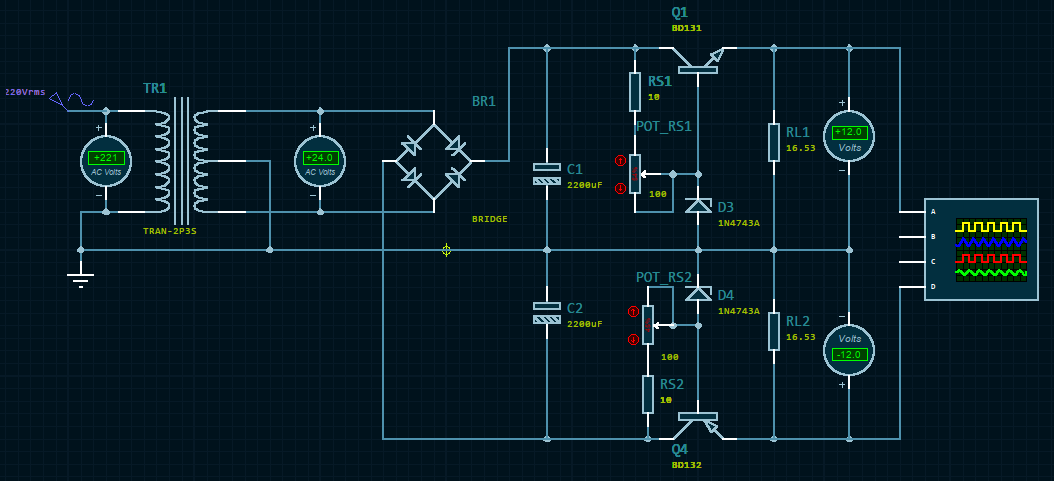
[picture p27: figure]

Tabla de materiales y componentes (Fuente regulada):

Componente | | Cantidad | | Costo
Resistencias | 10 Ω 1/4W | | 2 | | $5
Potenciómetros / preset | 100 Ω W | | 2 | | $1760
Capacitores | 2200μF 16V | | 2 | | $722
Diodos Zener | 1N4743A | | 2 | | $700
Transistores | BD132 (BJT-PNP) | | 1 | | $360
| BD131 (BJT-NPN) | | 1 | | $235
TOTAL | | | 10 | | $3782

Universidad Tecnológica Nacional – Facultad Regional Mendoza Ingeniería electrónica – Electrónica aplicada I – 2022 Anteproyecto para trabajo final de cátedra “Amplificador de 1 W para guitarra 20 Hz ~ 20 kHz” Alumno: Magni Genre, Exequiel Juan N.º Legajo: 46229
