Exequiel25/Amplificador-Mono-1-W-discreto/Presentacion_de_Proyecto_EA1.pptx

PROYECTO
EA1

Amplificador de 1 Watt para guitarra

Presentado por:

Magni Genre, Exequiel Juan

Universidad Tecnológica Nacional
Facultad Regional Mendoza

## ESTRUCTURA DE LA PRESENTACIÓN

1. ¿Por qué para guitarra?
2. Tercera etapa
3. Segunda etapa
4. Primera etapa
5. Resultado final
6. Anexo: Fuente regulada

## ¿POR QUÉ PARA GUITARRA?

## AMPLIFICADOR DE TENSIÓN

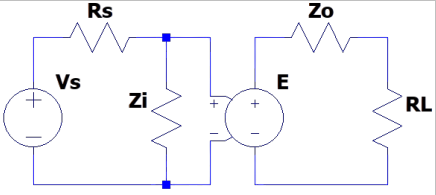
[picture p28: figure]

- Zi >> Rs
- Zo << RL donde RL = 8Ω → Vo = 4,05Vp
- Vs? → Av?
- Rs? → Zi?

## CONDICIONES POR EL INSTRUMENTO

- Señal de entrada Vs = 100~200 mVp; frecuencia inf. 82,4069Hz y frecuencia sup. 3,5kHz (armónica)
- Impedancia de entrada Zi >> 5~15kΩ
- Av = 4,05/0,1 = 40,5

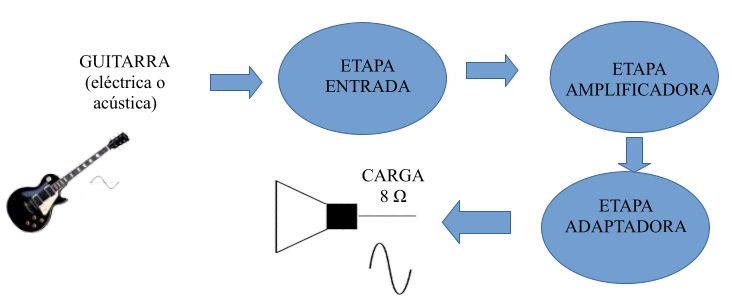
[picture p29: figure]

## TERCERA ETAPA

## ETAPA ADAPTADORA DE CARGA

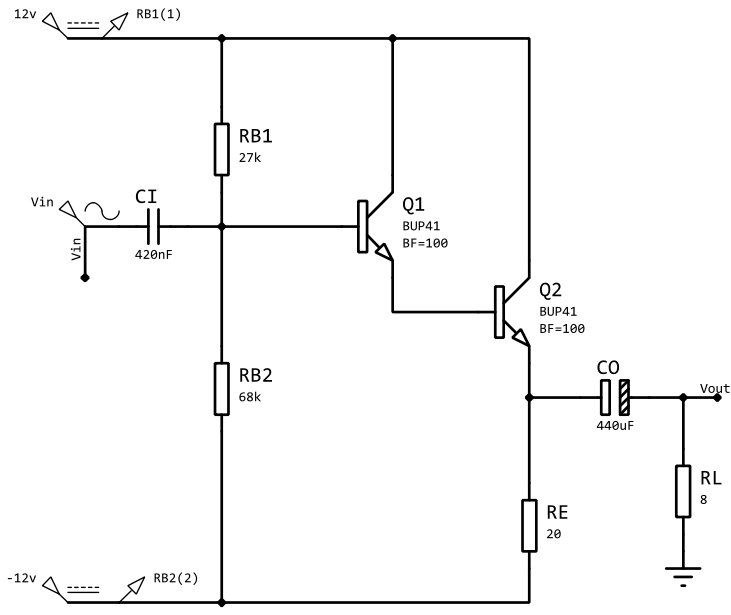
[picture p30: figure]

Potencia de transistores:
PQ1 = 102,2 mW
PQ2 = 7,344 W
PL = 1W
PDC = 22,4W
η(%) = 4,46%

Pmax = 10W

Pmax = 10W

## ETAPA ADAPTADORA DE CARGA

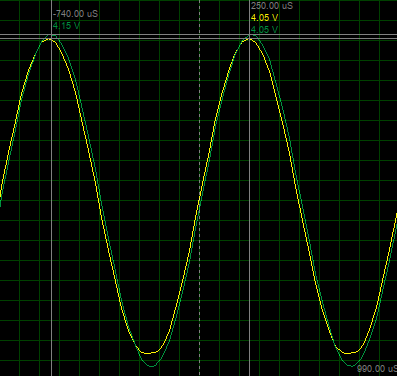
[picture p31: figure]

Vi = 4,15Vp
Vo = 4,05Vp
Av3 = 0,98
Av1 . Av2 = 41,33
|Av2| = 4,2
|Av1| = 10

## SEGUNDA ETAPA

## ETAPA AMPLIFICADORA

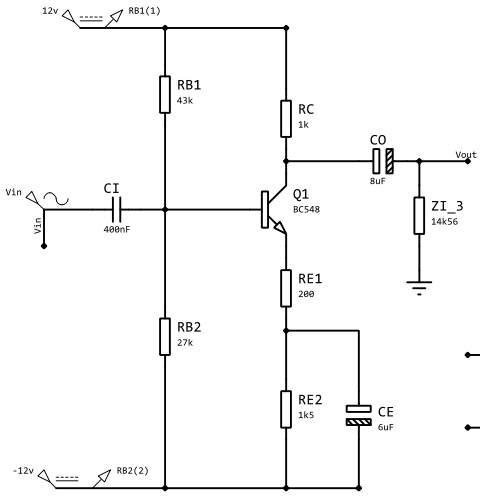
[picture p32: figure]

Potencia del transistor:
PQ1 = 56,69 mW

Pmax = 625mW

## ETAPA AMPLIFICADORA

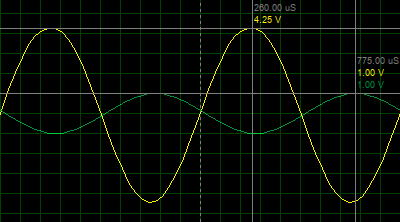
[picture p33: figure]

Vi = 1Vp Vo = 4,25Vp Av2 = -4,25

## PRIMERA ETAPA

## ETAPA DE ENTRADA

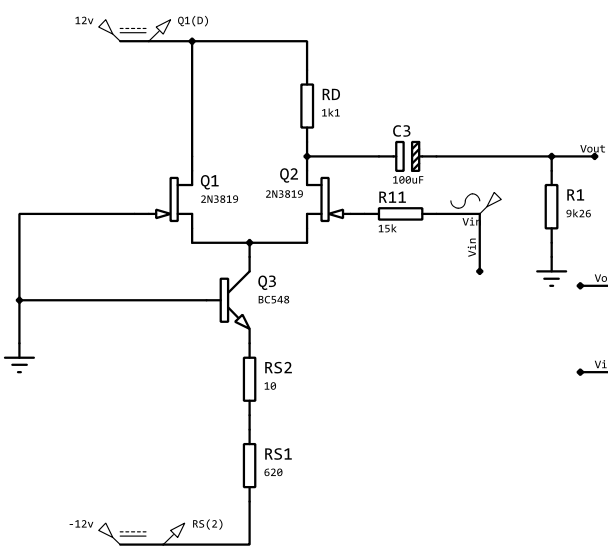
[picture p34: figure]

Potencia de transistores:
PQ1 = 106 mW
PQ2 = 19,42 mW
PQ3 = 14,65 mW

Pmax = 350mW

Pmax = 625mW

## ETAPA DE ENTRADA

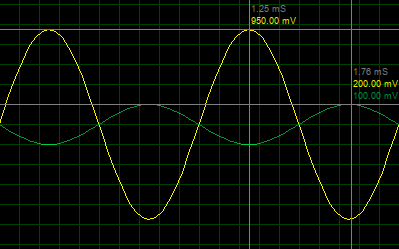
[picture p35: figure]

Vi = 100mVp
Vo = 950mVp
Av1 = -9,5

## RESULTADO FINAL

## AMPLIFICADOR DISEÑADO

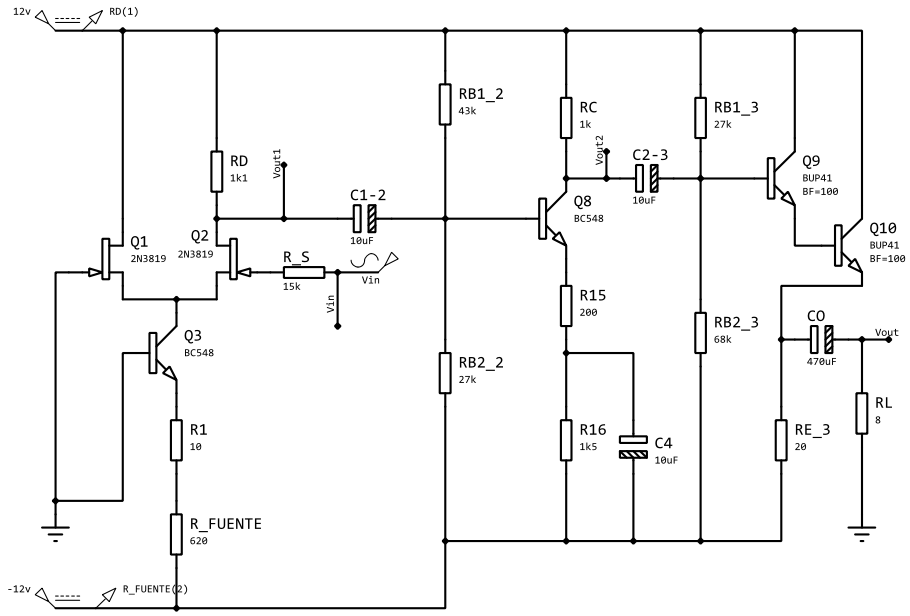
[picture p36: figure]

## AMPLIFICADOR DISEÑADO

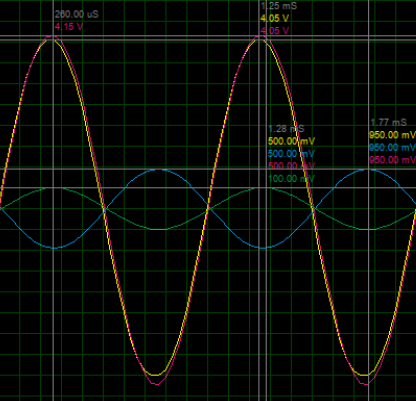
[picture p37: figure]

Vi = 100mVp
Vo = 4,05Vp
PL = 1Wrms
Av = 40,5
finf = 92Hz
fsup = 1,14MHz

## ANEXO: FUENTE DE DC

## FUENTE DE SALIDA FIJA REGULADA

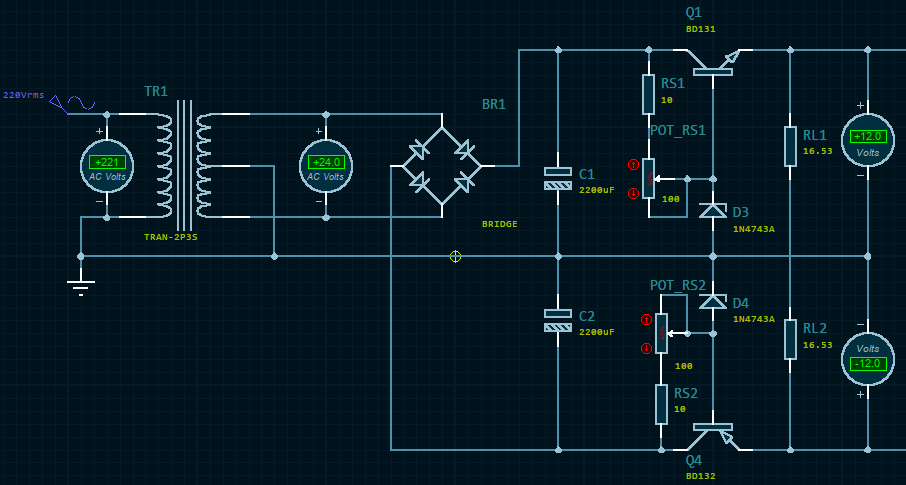
[picture p38: figure]

Potencia de cada regulador: P = 4,356W

## Muchas gracias por su atención
