Exequiel25/Amplificador-Mono-1-W-discreto/(list of files, drawings)

Other design files:
Proteus/Amplificador_sin_FuenteDC.pdsprj
Proteus/Etapa1.pdsprj
Proteus/Etapa2.pdsprj
Proteus/Etapa3.pdsprj
Proteus/FuenteDC.pdsprj
